luisgustavoalmeida/Controle_temperatura_ESP32/buzzer.cpp

/**
 * buzzer.cpp — Sequências não bloqueantes (tone/noTone)
 *
 * Pino: PINO_BUZZER (config.h). Chame atualizar() a cada PERIODO_LOOP_MS.
 * Clique do encoder: tone imediato a cada detente; retrigger no giro rápido.
 */

#include "buzzer.h"
#include "config.h"

void Buzzer::pararSinal() {
  noTone(PINO_BUZZER);
  digitalWrite(PINO_BUZZER, LOW);
}

void Buzzer::iniciar() {
  pinMode(PINO_BUZZER, OUTPUT);
  pararSinal();
  _padraoAtual = BUZZ_NENHUM;
  _faseSequencia = 0;
  _proximaAcaoMs = 0;
  _proximaAcaoCliqueUs = 0;
  _tocando = false;
}

void Buzzer::iniciarPadrao(BuzzerPadrao padrao) {
  pararSinal();
  _padraoAtual = padrao;
  _faseSequencia = 0;
  _tocando = true;
  _proximaAcaoMs = millis();
}

void Buzzer::iniciarPulsoClique() {
  if (_tocando && _padraoAtual == BUZZ_CLIQUE) {
    noTone(PINO_BUZZER);
    digitalWrite(PINO_BUZZER, LOW);
  }
  tone(PINO_BUZZER, BUZZ_CLIQUE_HZ);
  _padraoAtual = BUZZ_CLIQUE;
  _faseSequencia = 1;
  _tocando = true;
  _proximaAcaoCliqueUs = micros() + BUZZ_CLIQUE_US;
}

void Buzzer::tocarClique() {
  if (_tocando && _padraoAtual != BUZZ_CLIQUE) {
    pararSinal();
    _tocando = false;
  }
  iniciarPulsoClique();
}

void Buzzer::tocarConfirmacao() {
  iniciarPadrao(BUZZ_CONFIRMACAO);
}

void Buzzer::tocarMetaAtingida() {
  iniciarPadrao(BUZZ_META_ATINGIDA);
}

void Buzzer::tocarForaDaMeta() {
  iniciarPadrao(BUZZ_FORA_DA_META);
}

void Buzzer::tocarRedePresente() {
  iniciarPadrao(BUZZ_REDE_PRESENTE);
}

void Buzzer::tocarRedeAusente() {
  iniciarPadrao(BUZZ_REDE_AUSENTE);
}

uint8_t Buzzer::quantidadeNotas(BuzzerPadrao padrao) {
  switch (padrao) {
    case BUZZ_CONFIRMACAO: return 2;
    case BUZZ_META_ATINGIDA: return 3;
    case BUZZ_FORA_DA_META: return 3;
    case BUZZ_REDE_PRESENTE: return 1;
    case BUZZ_REDE_AUSENTE: return 1;
    default: return 0;
  }
}

uint16_t Buzzer::frequenciaHz(uint8_t indiceNota, BuzzerPadrao padrao) {
  switch (padrao) {
    case BUZZ_CONFIRMACAO:
      return (indiceNota == 0) ? 1800 : 2400;
    case BUZZ_META_ATINGIDA:
      if (indiceNota == 0) return 1500;
      if (indiceNota == 1) return 2000;
      return 2500;
    case BUZZ_FORA_DA_META:
      if (indiceNota == 0) return 2500;
      if (indiceNota == 1) return 2000;
      return 1500;
    case BUZZ_REDE_PRESENTE:
      return BUZZ_ZC_LIGADO_HZ;
    case BUZZ_REDE_AUSENTE:
      return BUZZ_ZC_DESLIGADO_HZ;
    default:
      return 0;
  }
}

uint16_t Buzzer::duracaoMs(uint8_t indiceNota, BuzzerPadrao padrao) {
  (void)indiceNota;
  switch (padrao) {
    case BUZZ_CONFIRMACAO: return 100;
    case BUZZ_META_ATINGIDA: return 120;
    case BUZZ_FORA_DA_META: return 140;
    case BUZZ_REDE_PRESENTE: return BUZZ_ZC_LIGADO_MS;
    case BUZZ_REDE_AUSENTE: return BUZZ_ZC_DESLIGADO_MS;
    default: return 0;
  }
}

void Buzzer::atualizar() {
  if (!_tocando) {
    return;
  }

  if (_padraoAtual == BUZZ_CLIQUE) {
    if ((long)(micros() - _proximaAcaoCliqueUs) < 0) {
      return;
    }
    pararSinal();
    _tocando = false;
    _padraoAtual = BUZZ_NENHUM;
    return;
  }

  unsigned long agora = millis();
  if (agora < _proximaAcaoMs) {
    return;
  }

  uint8_t totalFases = quantidadeNotas(_padraoAtual) * 2;
  if (_faseSequencia >= totalFases) {
    pararSinal();
    _tocando = false;
    _padraoAtual = BUZZ_NENHUM;
    return;
  }

  if (_faseSequencia % 2 == 0) {
    uint8_t indiceNota = _faseSequencia / 2;
    tone(PINO_BUZZER, frequenciaHz(indiceNota, _padraoAtual));
    _proximaAcaoMs = agora + duracaoMs(indiceNota, _padraoAtual);
  } else {
    noTone(PINO_BUZZER);
    _proximaAcaoMs = agora + 40;  // pausa entre notas
  }
  _faseSequencia++;
}
