luisgustavoalmeida/Controle_temperatura_ESP32/(commit log)

2026-06-02 Commit inicial: firmware de controle de temperatura do chuveiro (ESP32).
    Inclui malha PID com X9C104S, DS18B20, LCD I2C, encoder e buzzer;
    sketches de teste de hardware, OneWire local, documentação e PlatformIO.
    [Controle_temperatura_ESP32.ino, buzzer.cpp, buzzer.h, config.h, display_lcd.cpp, display_lcd.h, encoder_rotativo.cpp, encoder_rotativo.h]
2026-06-29 mudança para tpl0501
2026-06-30 Ultimos ajustes implementação do modo de controle de potencia e medidor de energia e tempo
2026-07-03 mudaça do potenciometro para zero-cros
